Pyroww/rds-async-traffic_light/docs/diagramas_tabelas/diagrama_implantacao.png

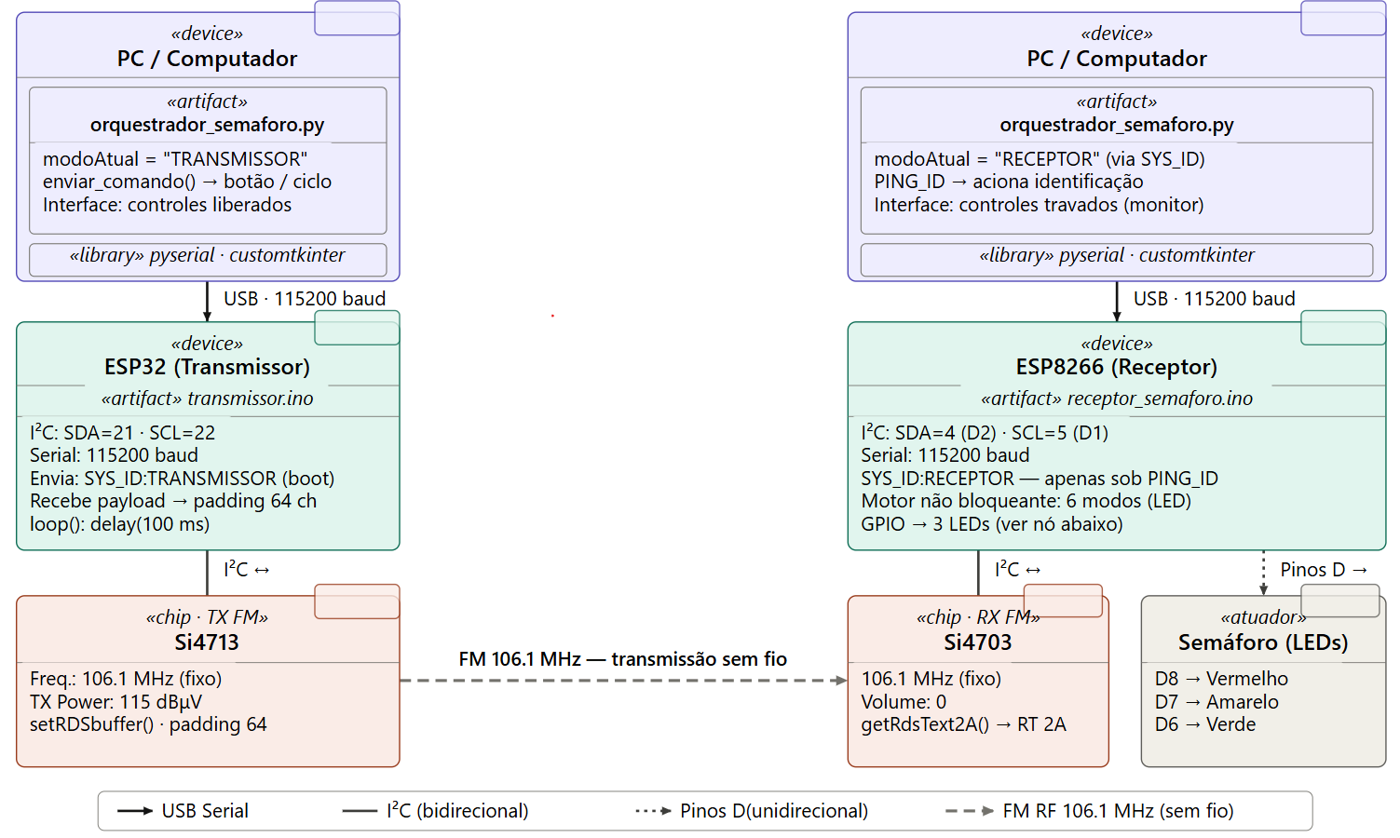
docs/diagramas_tabelas/diagrama_implantacao.png
