Pyroww/rds-async-traffic_light/docs/diagramas_tabelas/diagrama_sequencia.png

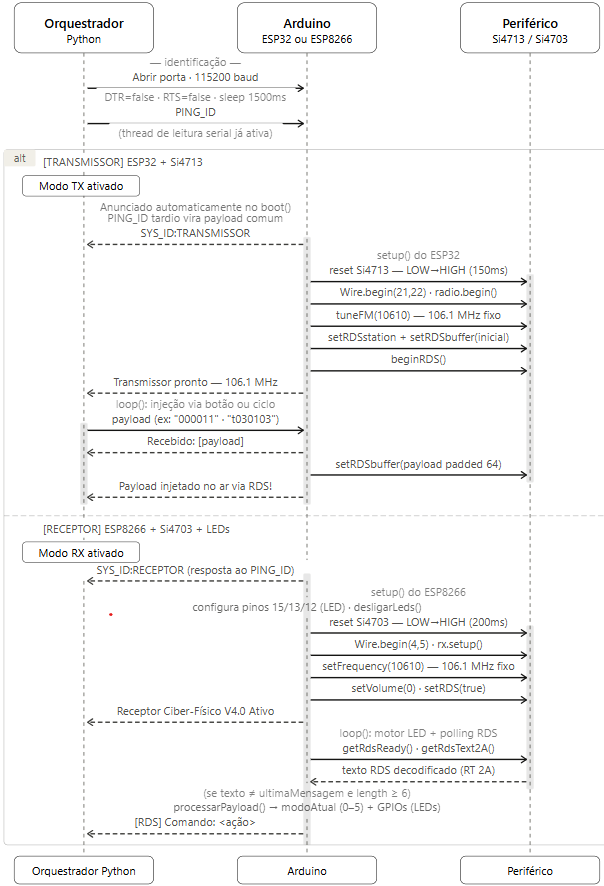
docs/diagramas_tabelas/diagrama_sequencia.png
