Pyroww/rds-async-traffic_light/docs/diagramas_tabelas/latencia.png

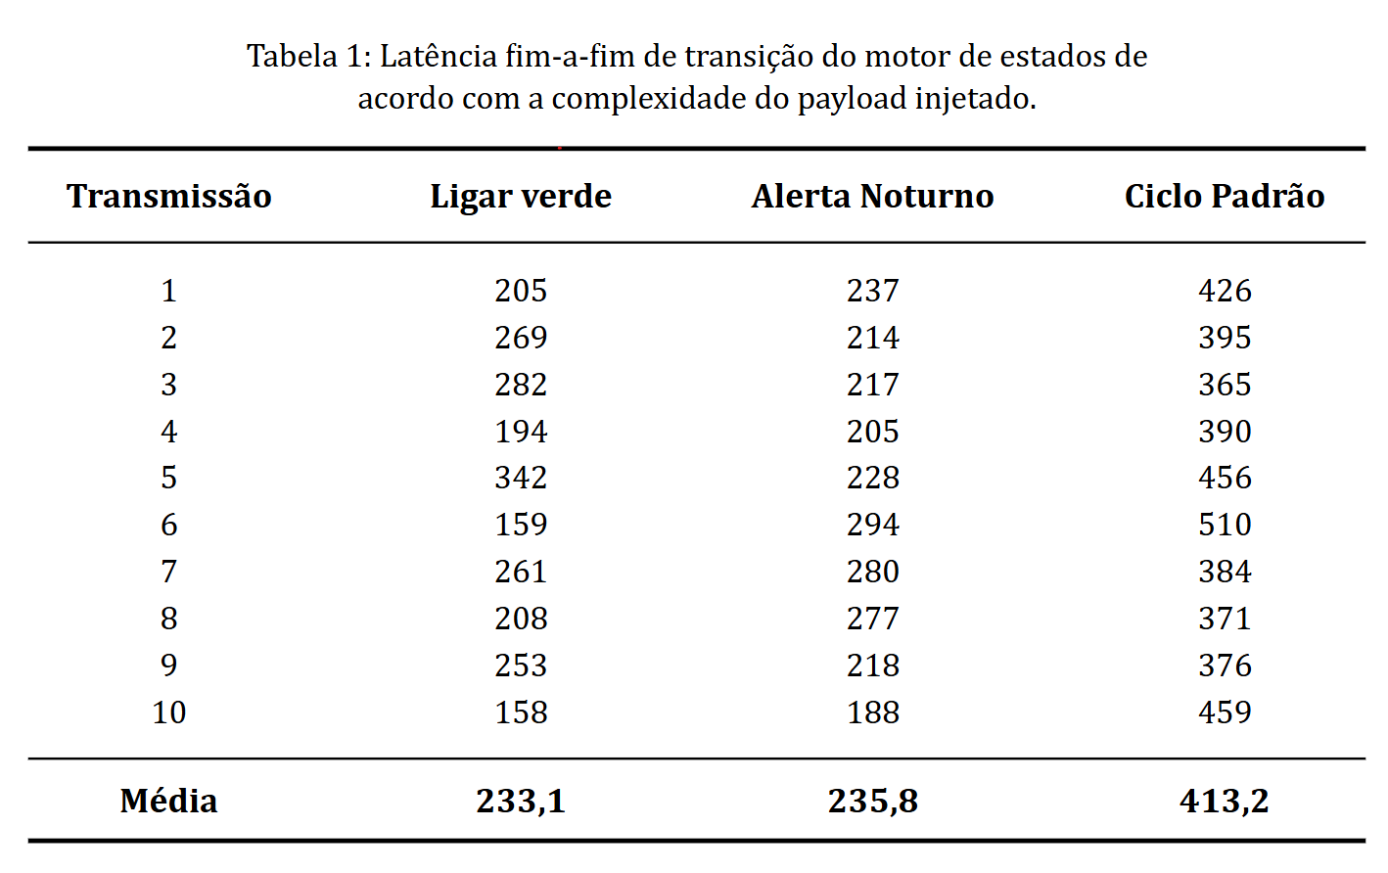
docs/diagramas_tabelas/latencia.png
