Pyroww/rds-async-traffic_light/media/modo_receptor.png

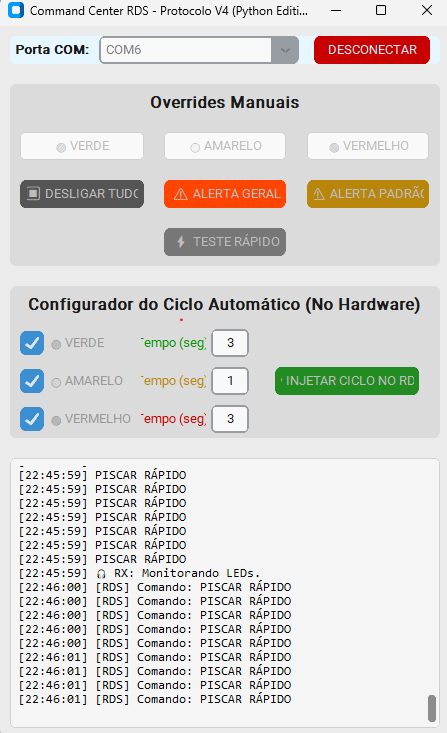
media/modo_receptor.png
