Pyroww/rds-async-traffic_light/media/modo_transmissor.png

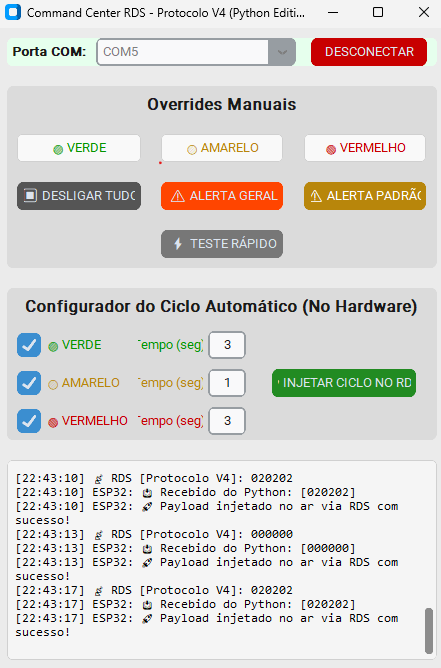
media/modo_transmissor.png
