Pyroww/rds-async-traffic_light/(notices)

Notices in the files:
README.md:
License: GPL v3
